Bunny350/OIWP-POWERFET/Base cover/README.md

# Base cover
This folder contains the FDM-printable accessory that prevents POWERFET from shorting and adds [DIN mounting from VORON Design](https://github.com/VoronDesign/Voron-Parts/tree/main/DIN_Mounts) for such unit.

Please check the unit's assembly manual for the printing guidelines.

Variant with heat sink is in the works.
