Bunny350/OIWP-POWERFET/Media/powerfet-g2.png

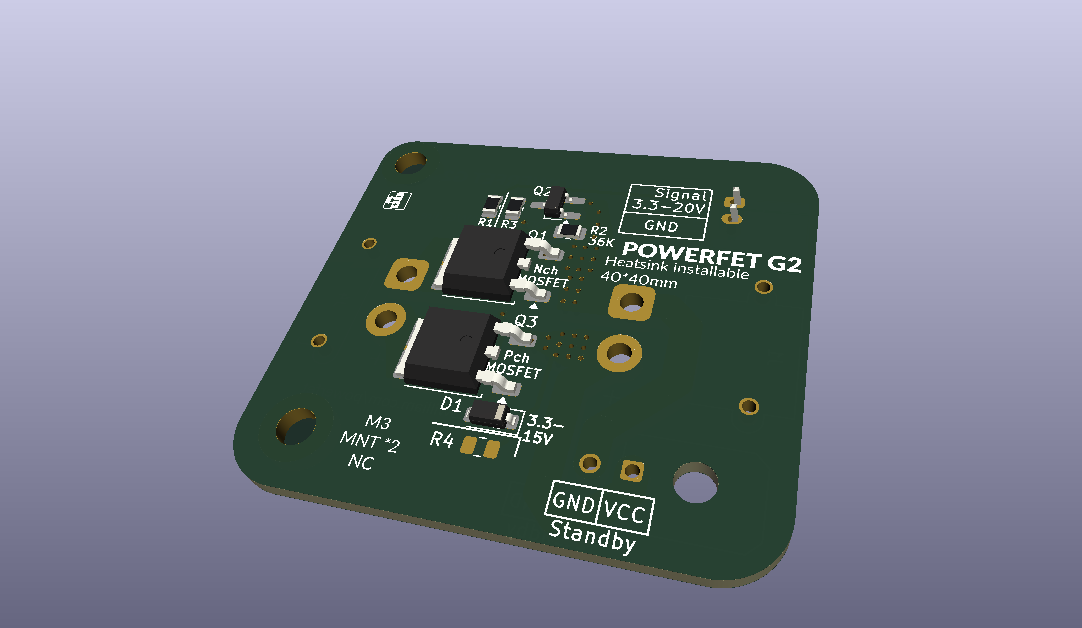
Media/powerfet-g2.png
