Bunny350/OIWP-POWERFET/Base cover/powerfet_g2_base_cover.step

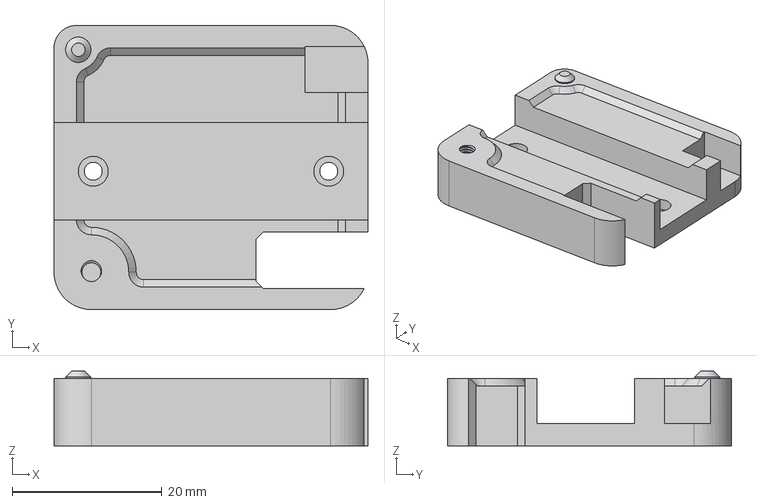
[picture p3: CAD file, 2026-08-20]
Base cover/powerfet_g2_base_cover.step
42.0 x 38.0 x 10.0 mm
