Bunny350/OIWP-POWERFET/(list of files, cad)

Other CAD files:
Base cover/powerfet_g2_base_cover.stl
