Bunny350/OIWP-POWERFET/schematics/powerfet-g2.pdf

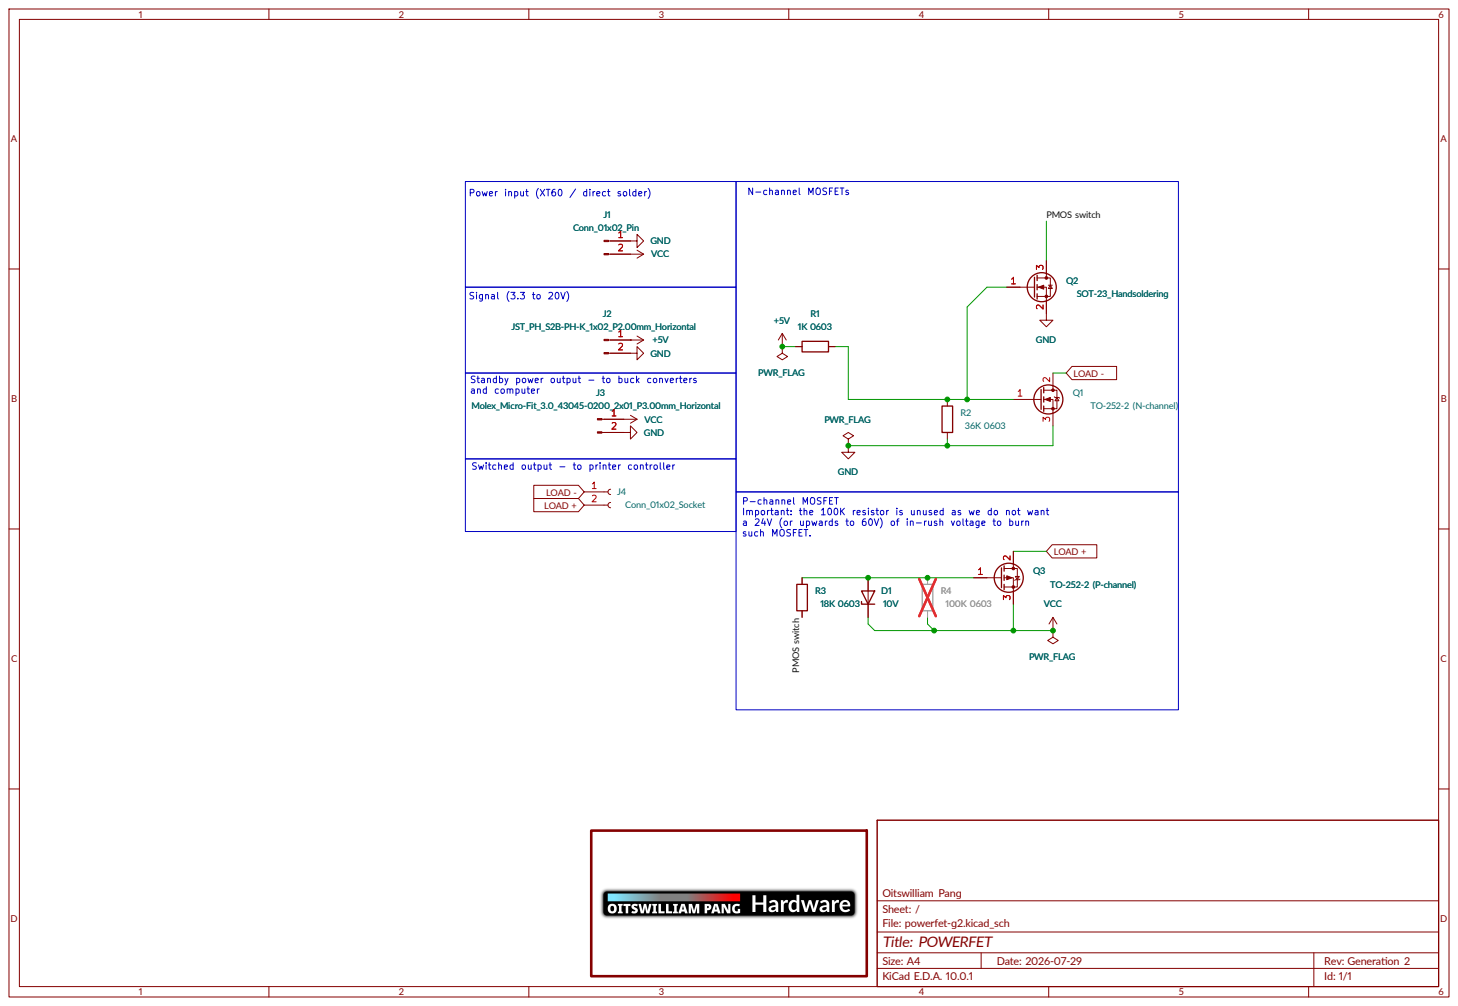
[picture p4: page 1]

LOAD - PMOS switch PMOS switch Switched output - to printer controller Signal (3.3 to 20V)

Important: the 100K resistor is unused as we do not want a 24V (or upwards to 60V) of in-rush voltage to burn
