Bunny350/OIWP-POWERFET/powerfet-g2.kicad_pcb

## KiCad design powerfet-g2.kicad_pcb (2026-08-20)

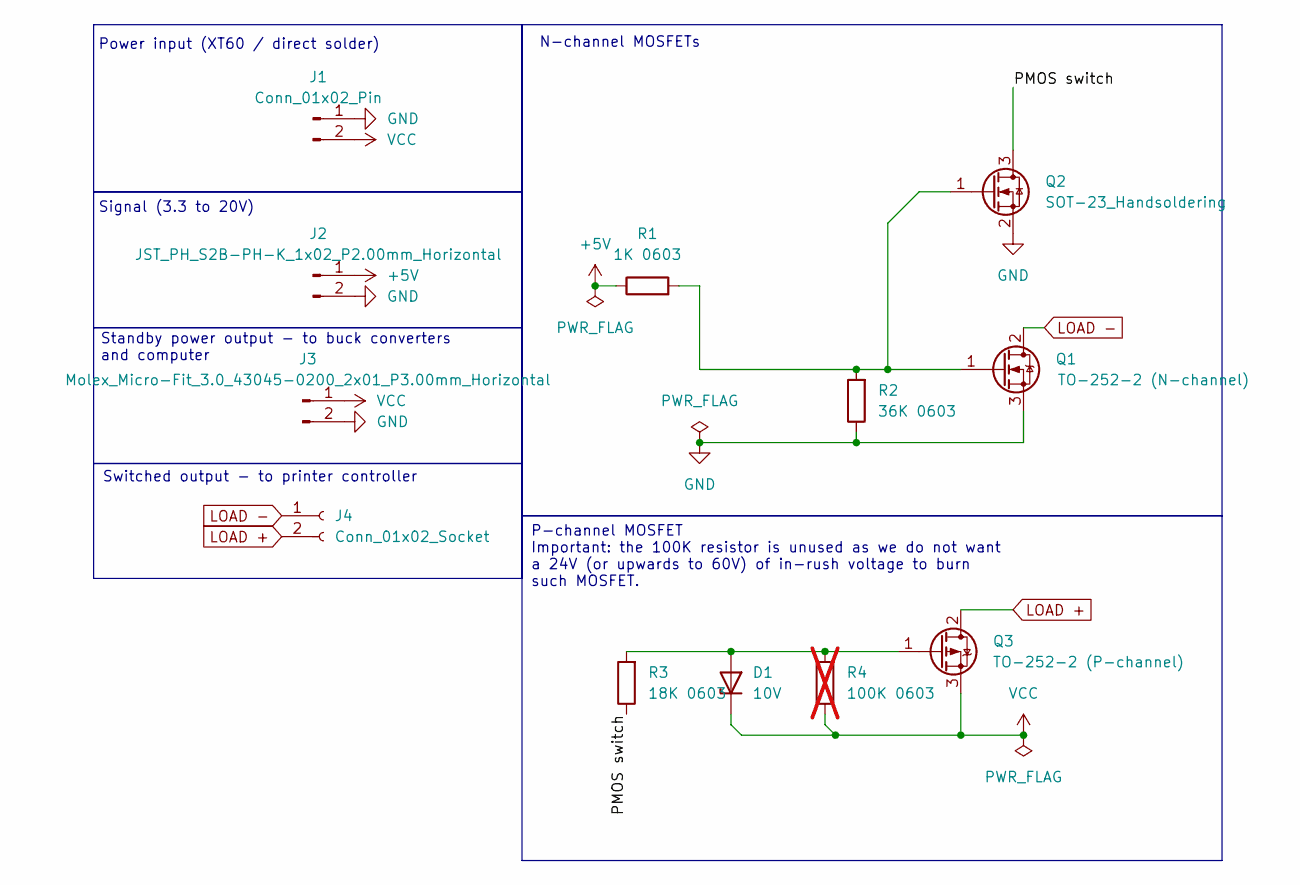
[picture p5: schematic powerfet-g2.kicad_sch, POWERFET]

Parts:
D1: 10V; D_SOD-123
J1: Conn_01x02_Pin; AMASS_XT30PW-M_1x02_P2.50mm_Horizontal
J2: JST_PH_S2B-PH-K_1x02_P2.00mm_Horizontal
J3: Molex_Micro-Fit_3.0_43045-0200_2x01_P3.00mm_Horiz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; Molex_Micro-Fit_3.0_43045-0200_2x01_P3.00mm_Horizontal
J4: Conn_01x02_Socket; AMASS_XT30PW-F_1x02_P2.50mm_Horizontal
Q1: TO-252-2 (N-channel); TO-252-2
Q2: SOT-23_Handsoldering
Q3: TO-252-2 (P-channel); TO-252-2
R1: 1K 0603; R_0805_2012Metric
R2: 36K 0603; R_0805_2012Metric
R3: 18K 0603; R_0805_2012Metric
R4: 100K 0603; R_0805_2012Metric; not fitted

Connections:
+5V: J2.1, R1.1
/PMOS switch: Q2.3 (D), R3.1
GND: J1.1, J2.2, J3.2, Q1.3 (S), Q2.2 (S), R2.1
LOAD +: J4.2, Q3.2 (D)
LOAD -: J4.1, Q1.2 (D)
unnamed: D1.2 (A), Q3.1 (G), R3.2, R4.2
unnamed: Q1.1 (G), Q2.1 (G), R1.2, R2.2
VCC: D1.1 (K), J1.2, J3.1, Q3.3 (S), R4.1

Notes on the sheet:
P-channel MOSFET Important: the 100K resistor is unused as we do not want a 24V (or upwards to 60V) of in-rush voltage to burn such MOSFET.
Power input (XT60 / direct solder)
Standby power output - to buck converters and computer
N-channel MOSFETs
Signal (3.3 to 20V)
Switched output - to printer controller

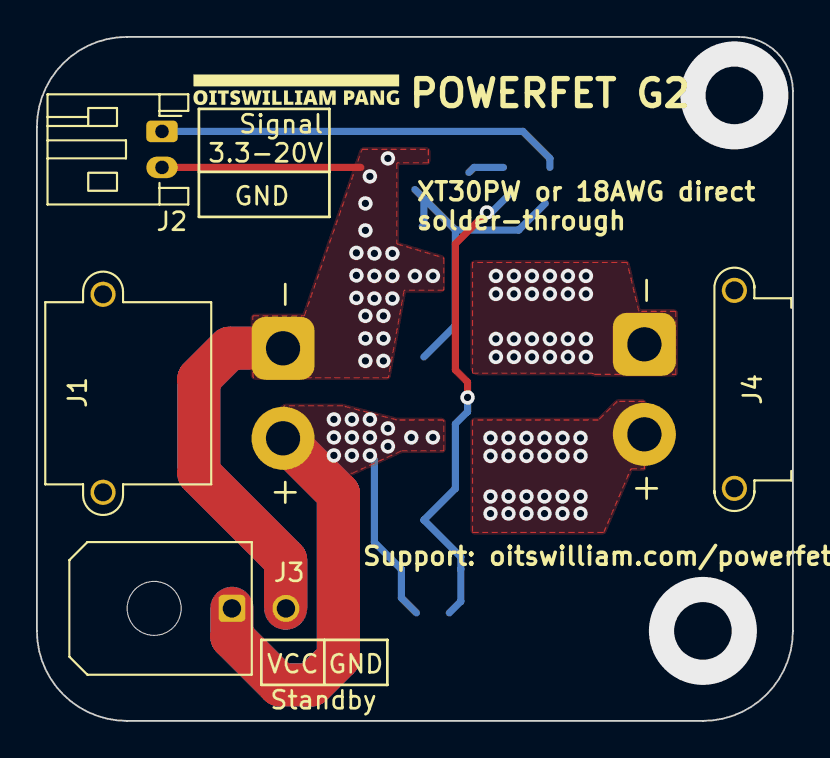
[picture p6: board powerfet-g2.kicad_pcb from above]

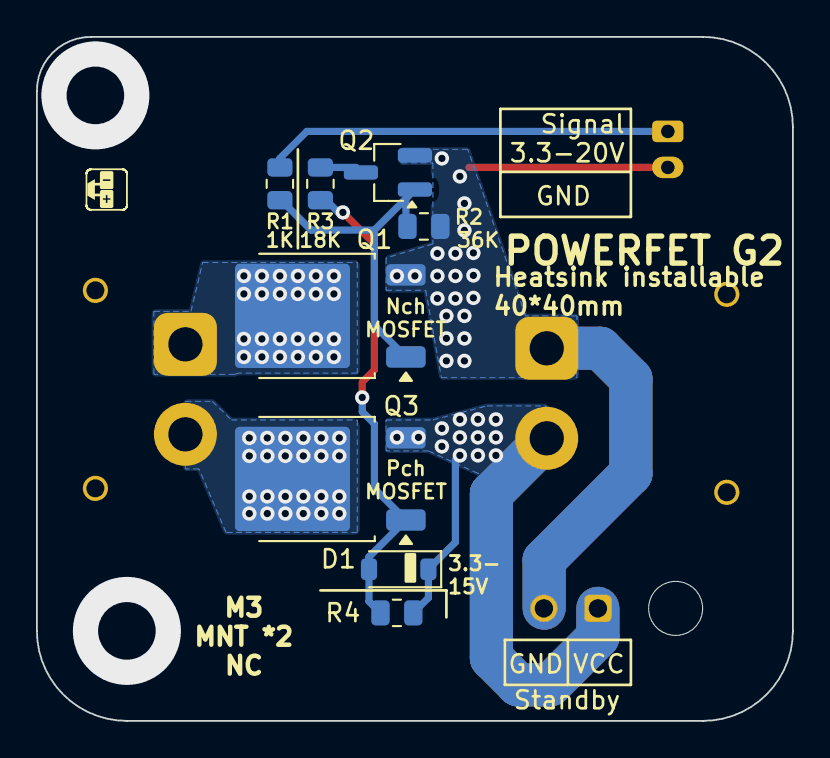
[picture p7: board powerfet-g2.kicad_pcb from below]

Board: 2 copper layers, 42.0 x 38.0 mm, 12 parts (8 on the bottom side), 8 nets.
