Bunny350/OIWP-POWERFET/(commit log)

2026-08-20 Introduce POWERFET G2 under early access
    [powerfet-g2.kicad_pcb, powerfet-g2.kicad_sch, powerfet_g2_base_cover.step, powerfet_g2_base_cover.stl]
2026-08-20 Update README.md
    Adjust image size and that path was blob.
    Add max current from standby connector and fix missing phrase.
